Any-Winter-4079/Transformer_Robot/computer_code/undistortion_and_rectification/images/undistorted_and_rectified_calibration_images/example_1.jpg

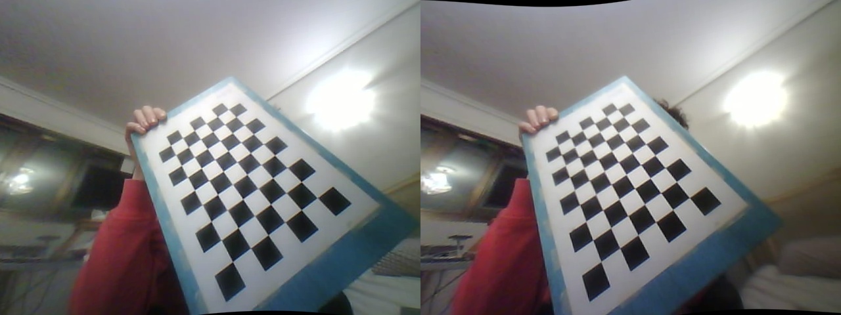
computer_code/undistortion_and_rectification/images/undistorted_and_rectified_calibration_images/example_1.jpg
