Any-Winter-4079/Transformer_Robot/computer_code/LMM/input_images/left_turn.png

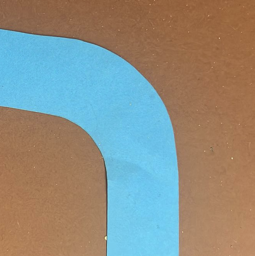
computer_code/LMM/input_images/left_turn.png
