Any-Winter-4079/Transformer_Robot/computer_code/LMM/input_images/right_turn.png

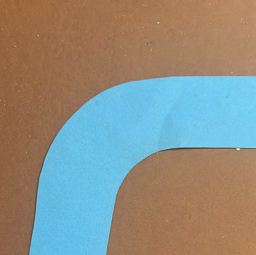
computer_code/LMM/input_images/right_turn.png
