Any-Winter-4079/Transformer_Robot/computer_code/LMM/input_images/straight_ahead.png

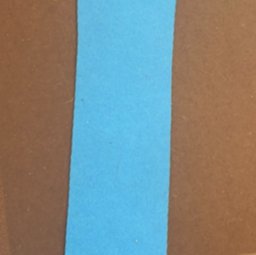
computer_code/LMM/input_images/straight_ahead.png
