Any-Winter-4079/Transformer_Robot/resources/iris.png

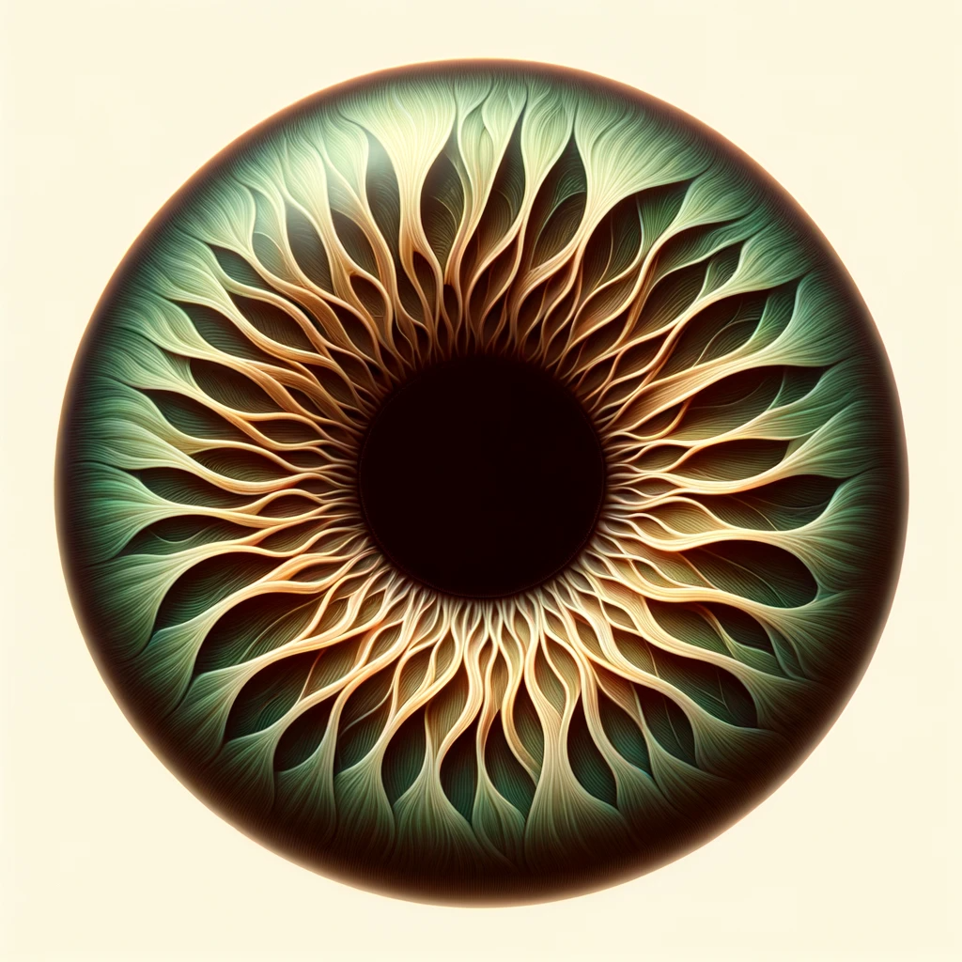
resources/iris.png
