Any-Winter-4079/Transformer_Robot/computer_code/LMM/results/LLaVA-1.5-13b-4bit_detail_image_for_left_turn.png

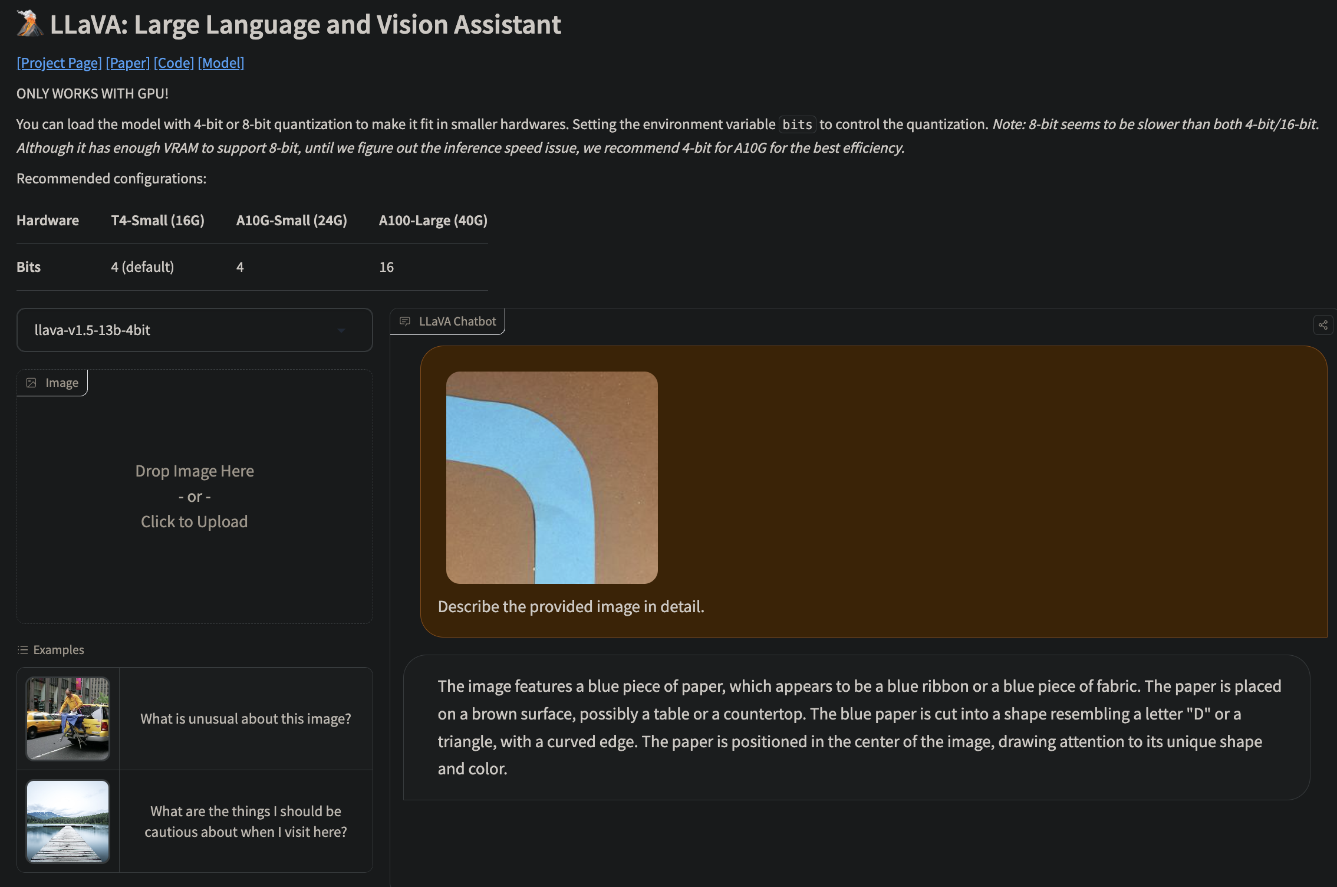
computer_code/LMM/results/LLaVA-1.5-13b-4bit_detail_image_for_left_turn.png
