Any-Winter-4079/Transformer_Robot/computer_code/LMM/results/LLaVA-1.5-13b-4bit_find_next_move_for_left_turn_marked.png

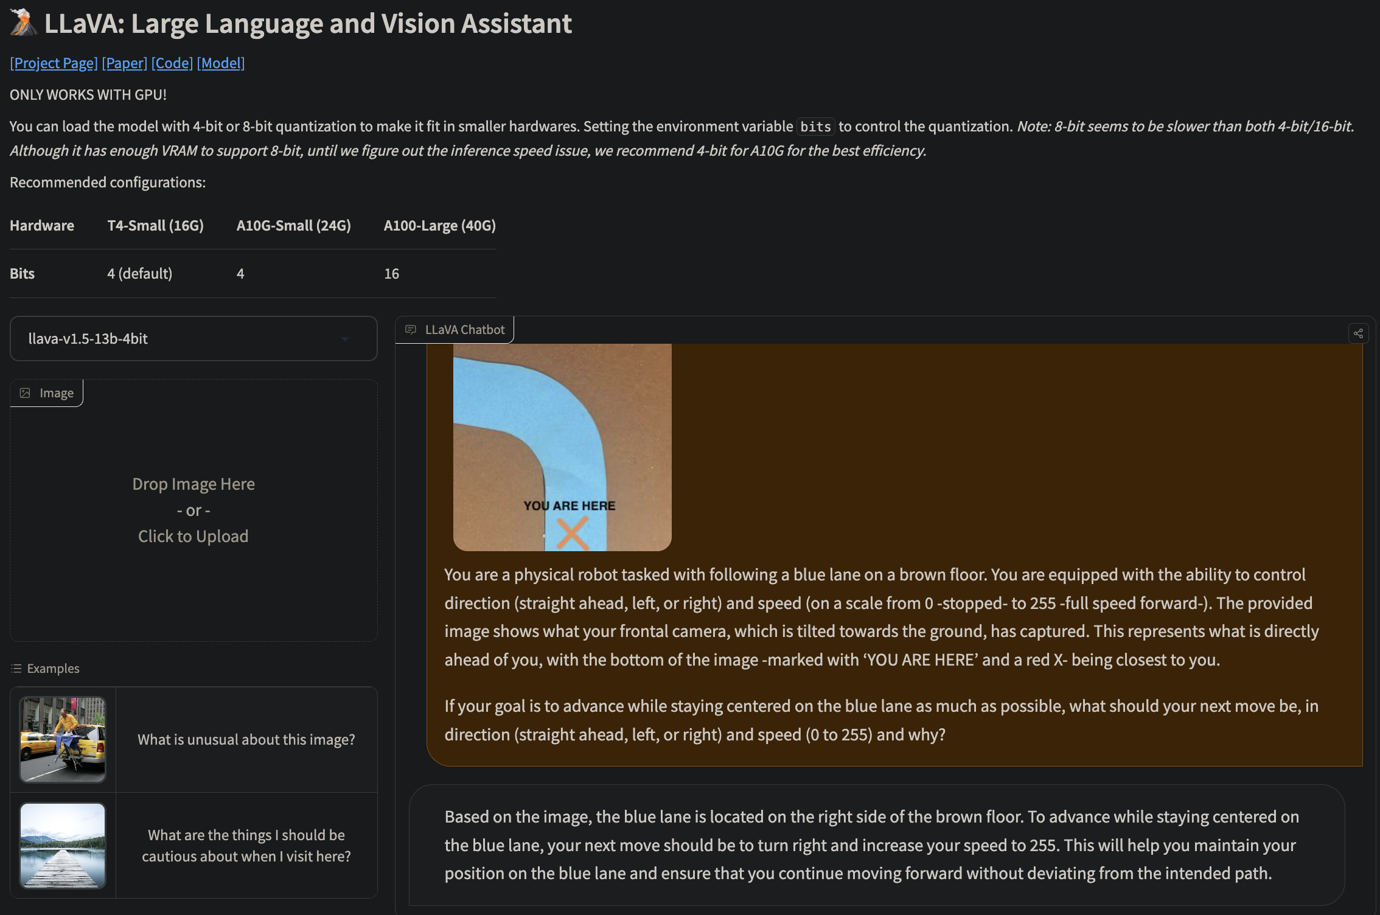
computer_code/LMM/results/LLaVA-1.5-13b-4bit_find_next_move_for_left_turn_marked.png
