Any-Winter-4079/Transformer_Robot/computer_code/LMM/results/LLaVA-1.6-34b-4bit_detail_image_for_right_turn.png

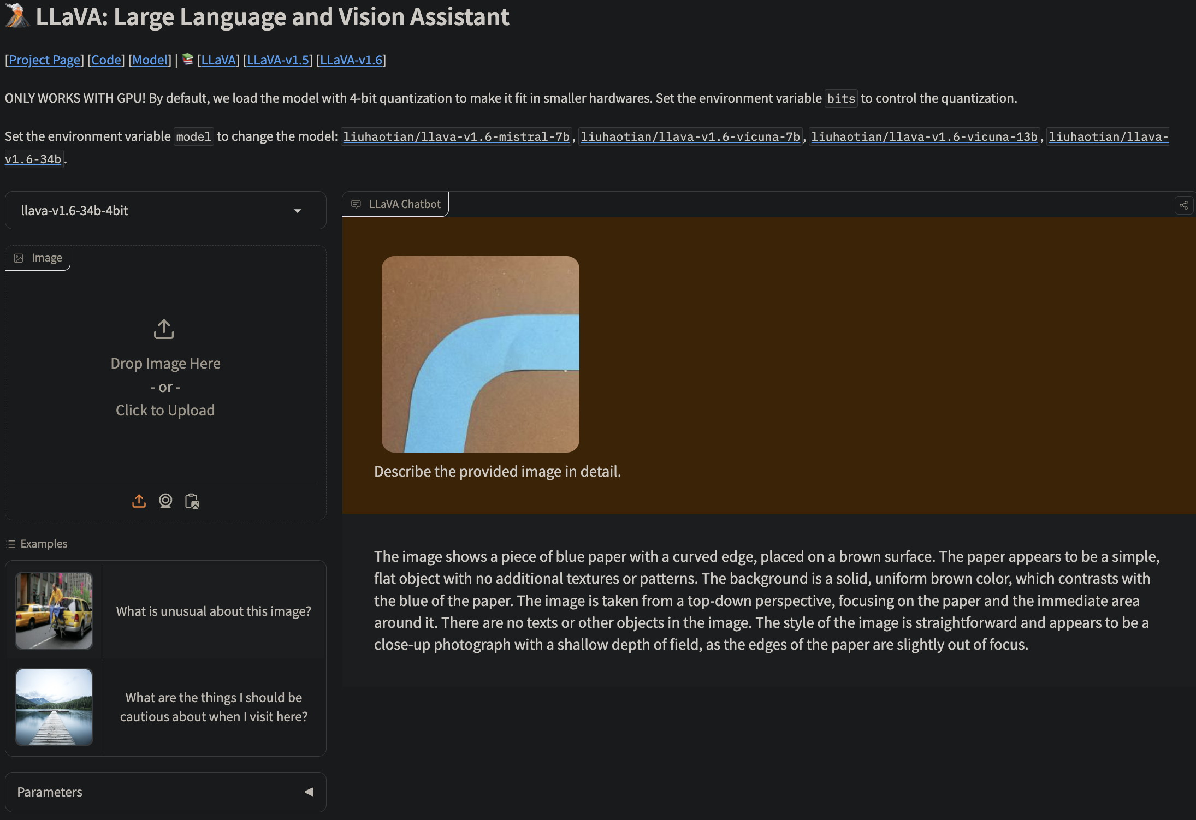
computer_code/LMM/results/LLaVA-1.6-34b-4bit_detail_image_for_right_turn.png
