Any-Winter-4079/Transformer_Robot/computer_code/LMM/results/LLaVA-1.6-34b-4bit_find_next_move_for_straight_ahead.png

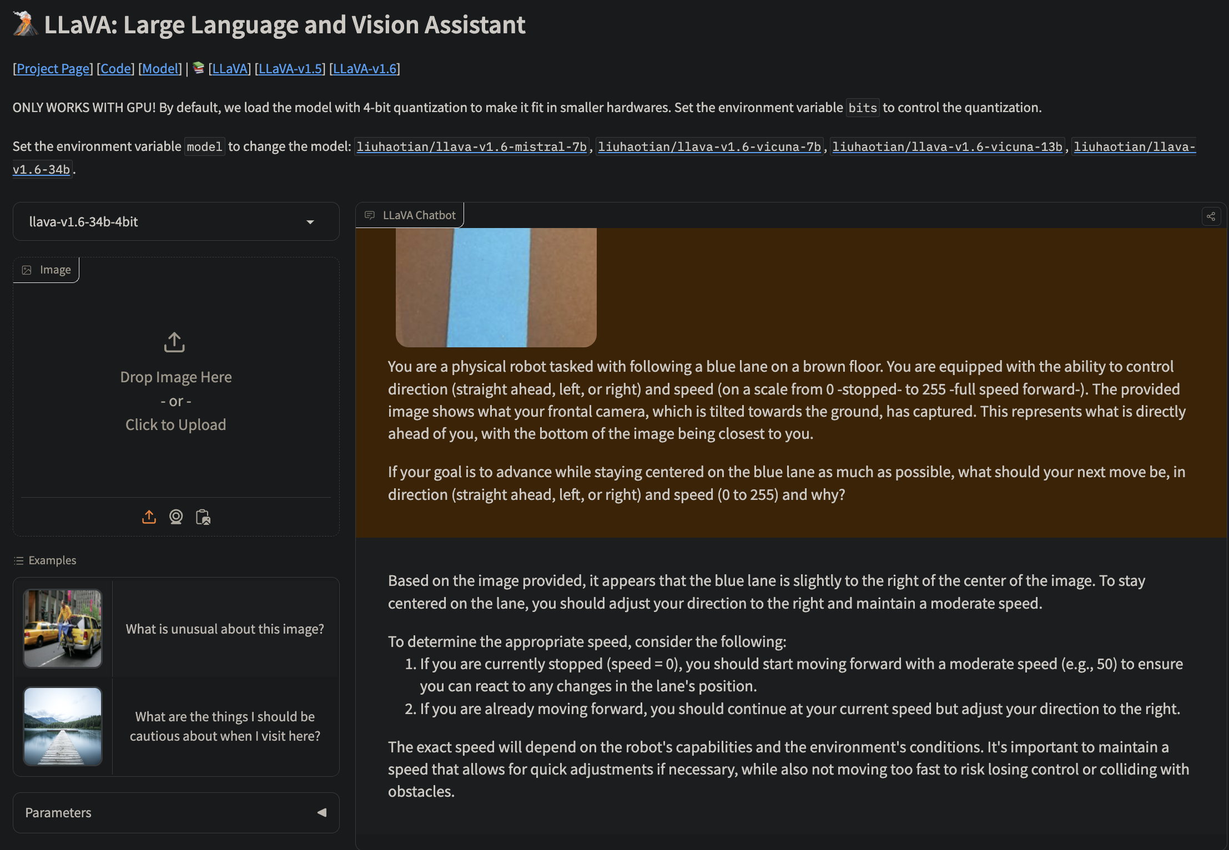
computer_code/LMM/results/LLaVA-1.6-34b-4bit_find_next_move_for_straight_ahead.png
