Any-Winter-4079/Transformer_Robot/computer_code/LMM/results/moondream1_detail_image_for_left_turn.png

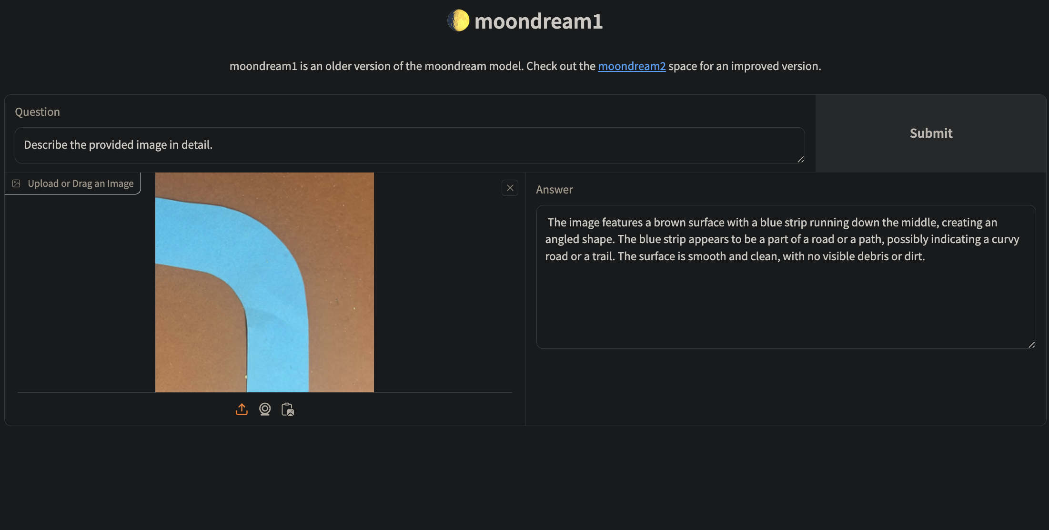
computer_code/LMM/results/moondream1_detail_image_for_left_turn.png
