Any-Winter-4079/Transformer_Robot/computer_code/LMM/results/moondream1_find_next_move_for_arrow_left_marked.png

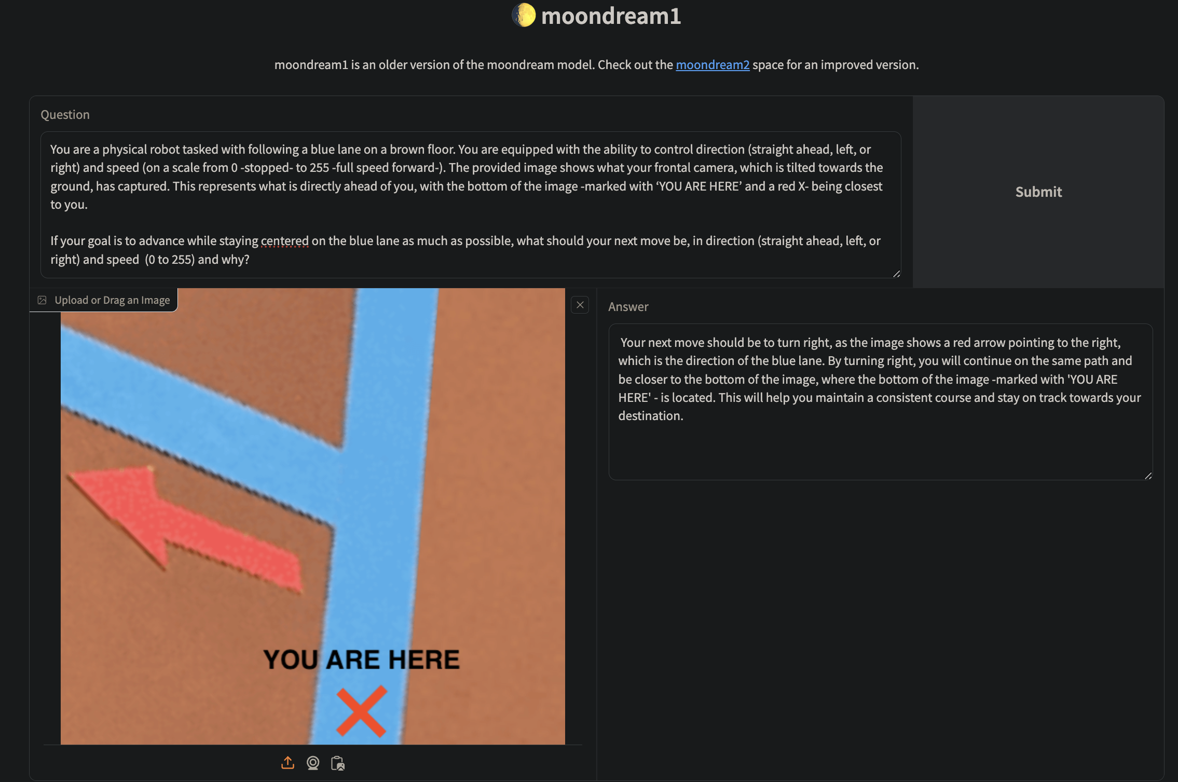
computer_code/LMM/results/moondream1_find_next_move_for_arrow_left_marked.png
