Any-Winter-4079/Transformer_Robot/computer_code/LMM/results/moondream2_find_next_move_for_right_turn.png

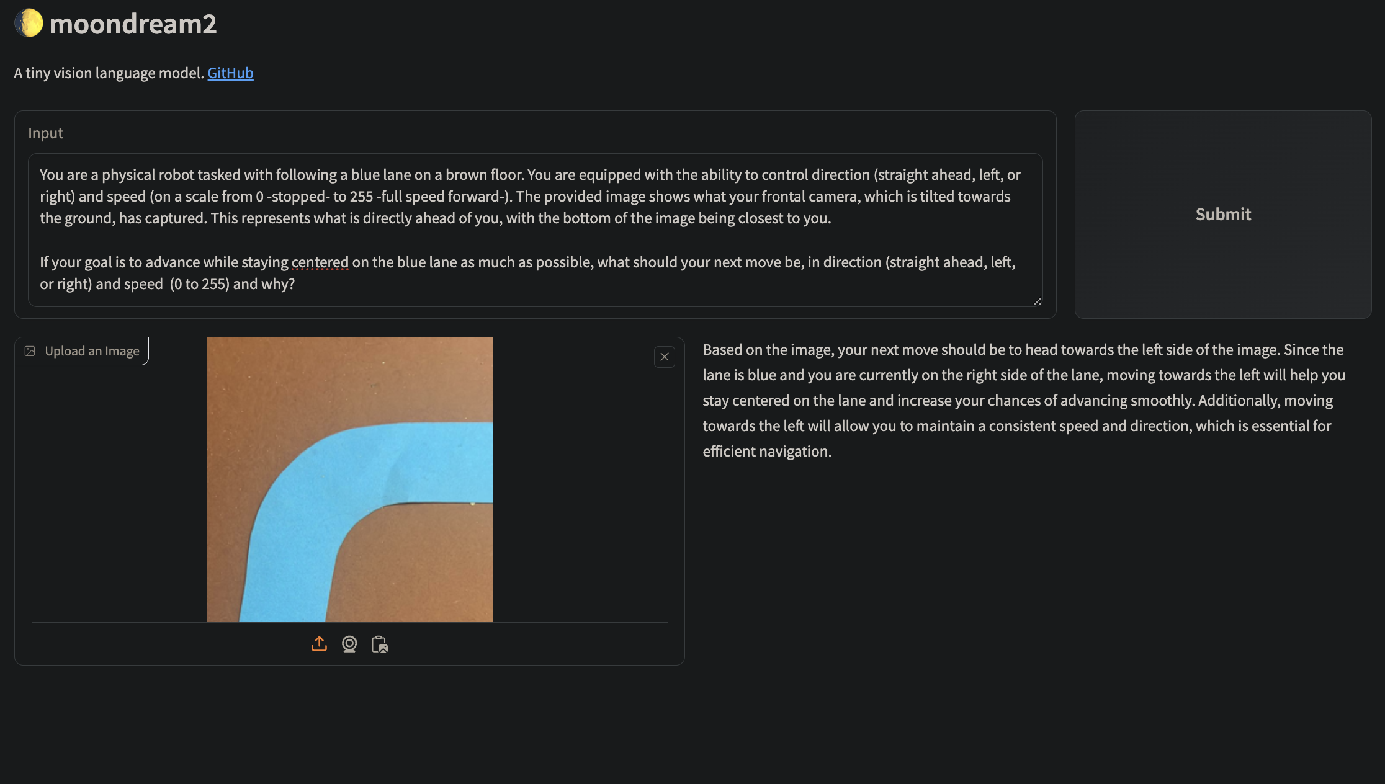
computer_code/LMM/results/moondream2_find_next_move_for_right_turn.png
