Any-Winter-4079/Transformer_Robot/computer_code/LMM/results/nanoLLaVA-qwen-1.5_detail_image_for_straight_ahead.png

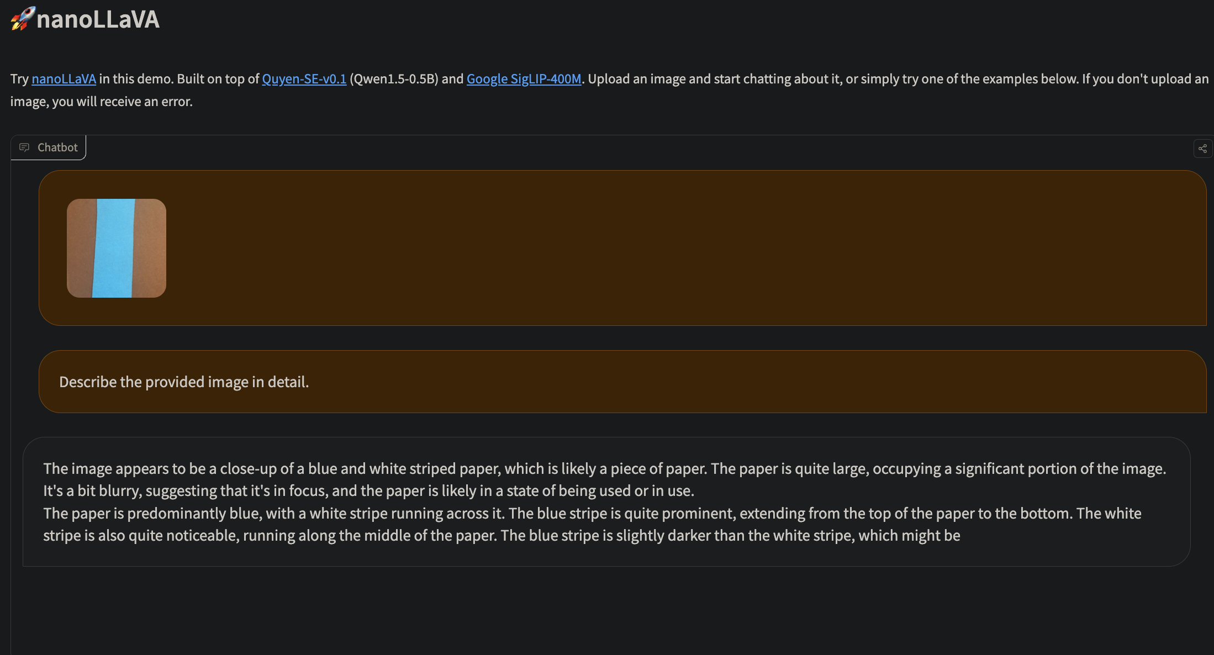
computer_code/LMM/results/nanoLLaVA-qwen-1.5_detail_image_for_straight_ahead.png
