Any-Winter-4079/Transformer_Robot/(commit log)

2024-01-23 Code for m5stackwide ESP32-CAM (robot's left eye)
2024-01-23 Code for aithinker ESP32-CAM (robot's right eye)
2024-01-24 Update on the day/night remark as it's inconclusive. Actually, power may be more important (15fps with dedicated 4.8V battery).
2024-01-24 Code for servo angle change from computer
2024-01-25 Code for ESP32-CAMs frame captures for calibration
2024-01-31 Code for Uno-L298N communication to test the motors
2024-01-31 Allow to set JPEG_QUALITY and FRAME_SIZE before capturing images for calibration
2024-01-31 Initial README.md w/ ESP32-CAMs performance
2024-01-31 Handle camera reinitialisation after updating the config
2024-02-10 Exchange of robot cameras (left and right eye) in new eye mechanism to move left/right/up/down
2024-02-11 Test sketch for the 2 SG-90 servos to move the eyes
2024-02-12 New angles for the servos after mechanical update
2024-02-12 Comment about leaving Ai-Thinker's antenna unobstructed
2024-02-12 Add second servo to the move_servo(s) test script
2024-02-13 Steps to create and build the robot's chassis
2024-02-13 Update chassis.md with fixes
2024-02-13 Add final instructions to chassis.md
2024-02-13 Update chassis.md to point to move_motors.ino
2024-02-14 New instructions: flashing sketch to the cameras
2024-02-15 Set capture quality to 4 for calibration
2024-02-15 Early version of calibration script
2024-02-29 Perform face recognition on the camera's frames
2024-03-06 Create mixtral-8x7b-instruct-q50_GSM8K_2024-03-06_05-55-35_seed_1337_Dec3P_all samples.txt
2024-03-06 Create mixtral-8x7b-instruct-q50_GSM8K_2024-03-06_16-33-55_seed_1337_Dec4MP_all samples.txt
2024-03-06 Create mixtral-8x7b-instruct-q50_GSM8K_2024-03-06_23-09-31_seed_1337_CoT_all samples.txt
2024-03-08 Create new_code_mixtral-8x7b-instruct-q50_GSM8K_2024-03-07_19-07-14_seed_1337_Dec4MP_all samples.txt
2024-03-09 Create new_code_mixtral-8x7b-instruct-q50_GSM8K_2024-03-09_01-41-48_seed_1337_Dec8MP_Own_all samples.txt
2024-03-09 Create mixtral-8x7b-instruct-q50_GSM8K_2024-03-09_16-37-39_seed_7625_CoT_all samples.txt
2024-03-10 Create mixtral-8x7b-instruct-q50_GSM8K_2024-03-09_22-23-54_seed_966_CoT_all samples.txt
2024-03-10 Update and rename mixtral-8x7b-instruct-q50_GSM8K_2024-03-06_23-09-31_seed_1337_CoT_all samples.txt to mixtral-8x7b-instruct-q50_GSM8K_2024-03-09_08-49-58_seed_1337_CoT_all samples.txt
2024-03-14 Create mixtral-8x7b-instruct-q5_0_GSM8K_2024-03-14_18-24-14_seed_1337_PAL_all samples.txt
2024-03-19 Rename new_code_mixtral-8x7b-instruct-q50_GSM8K_2024-03-07_19-07-14_seed_1337_Dec4MP_all samples.txt to new_code_mixtral-8x7b-instruct-q5_0_GSM8K_2024-03-07_19-07-14_seed_1337_Dec4MP_all samples.txt
2024-03-19 Rename new_code_mixtral-8x7b-instruct-q50_GSM8K_2024-03-09_01-41-48_seed_1337_Dec8MP_Own_all samples.txt to new_code_mixtral-8x7b-instruct-q5_0_GSM8K_2024-03-09_01-41-48_seed_1337_Dec8MP_Own_all samp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
2024-03-23 Create v2_mixtral-8x7b-instruct-q5_0_GSM8K_test_2024-03-23_08-49-55_seed_1337_CoT_all samples.txt
2024-03-25 Create v2_mixtral-8x7b-instruct-q5_0_GSM8K_test_2024-03-25_12-11-05_seed_1337_PAL_5_iters_all samples.txt
2024-04-09 Create v2_mixtral-8x7b-instruct-q5_0_GSM8K_test_2024-04-09_17-57-31_seed_1337_PAL_CoT_3_iters_all samples.txt
2024-06-17 Create v2_Cerebrum-1.0-8x7b_GSM8K_test_2024-03-20_17-13-30_seed_1337_PAL_all samples.txt
